Nicktedie123/Schallplattenspieler-VPE/cad/README.md

# CAD (STEP)

Hier liegen die neutralen CAD-Exporte (`.step`), die in jedem CAD-System geöffnet werden können.

**Export aus Fusion 360:** *Datei → Exportieren → Dateityp „STEP-Dateien (*.step)“*.

Empfohlene Dateinamen: `schallplattenspieler-gesamt.step`, `tonarm.step`, `zentrierdorn.step`.
