Nicktedie123/Schallplattenspieler-VPE/docs/anforderungsliste.pdf

# 3. Abgleich Anforderungsliste

F
/
W
Nr. | Bezeichnung | Wert gefordert | Wert aktuell | Überprü fung
1. Energie / Elektrik / Elektronik
F | 1.1 | Stromversorgung | mittels externem Netzteil DC 12V | DC 12V — Buchse 8320N131 vorhanden | CAD
F | 1.2 | Gesetze, Vorschriften und Bestimmungen für Elektrogeräte | zu beachten | Zu beachten — noch nicht vollst. geprüft | Norm-Prüfung
F | 1.3 | Schutz gegen elektrischen Schlag | kein Schaden | Alle spannungsführenden Teile abgedeckt (Abdeckung, Deckel_Motor) | CAD
F | 1.4 | Berührungs- und Fremdkörperschutz | keine Berührung | Abdeckungen auf allen Öffnungen vorhanden | CAD
F | 1.5 | Lautsprecheranschlus s | kabelgebunden | 2× 5432T17 GoldPlated RCA Buchsen integriert | CAD
2 | GEOMETRIE
F | 2.1 | Plattendurchmesser | 12 Zoll | Plattenteller — Ø 295 mm — passt für 12" | CAD
W | 2.2 | Plattendurchmesser | 7 und 12 Zoll
F | 2.3 | Zentrische Aufnahme der Platte | vorhanden | Zentrierdorn — Ø 7,24 mm | CAD
F | 2.4 | Keine scharfkantigen Teile | keine Kanten | Alle Kanten gefilleted in Fusion 360 | CAD

### 3 MECHANIK

3.1 | Bedienung des Tonarms | manuelle Bedienung | Lift-Hebel Manuelle Betätigung | CAD
3.2 | Horizontale Bewegung des Tonarms | geführt | Drehlager im pillar | CAD
3.3 | Vertikale Bewegung des Tonarms | geführt | Liftsystem_prototyp — Führung durch Drehlager | CAD

3.4 | | abwärts gedämpft | Feder v7 vorhanden — Dämpfung noch zu validieren | CAD
3.5 | Vertikale Bewegung des Tonarms | <30° | Mechanischer Anschlag im Liftsystem
3.6 | Auflagekraft des Tonarms | <40mN | Gegengewicht einstellbar
3.7 | Hohe Stabilität des Tonarms | keine bleibenden Verformungen | PLA-Tonarm — FEMAnalyse noch ausstehend | FEM
3.8 | Hohe Steifigkeit des Tonarms | möglichst geringe Verformungen | PLA-Tonarm — FEMAnalyse noch ausstehend | FEM
3.9 | Plattentellerantrieb | elektrisch | DC-Motor 8320N131 — elektrisch angetrieben | CAD
3.1 0 | Plattentellerantrieb | manuell ein-/ausschaltbar | Rocker Switch 7395K11 — EIN/AUS | CAD
3.1 1 | Plattentellerdrehzah | 33 1/3 min-1 | Slide Switch 66065K23 — 33⅓ RPM | CAD
3.1 2 | Plattentellerdrehzahl | 33 1/3 min-1 und 45 min-1 | Slide Switch — umschaltbar 33⅓ / 45 RPM | CAD
3.1 3 | Vibration auf Teller | geringe Übertragung | Riemenantrieb (Riemen v2) entkoppelt Motor vom Teller | CAD

4 ERGONOMIE
4.1 | Handhabungsteile | Ergonomische Griffform | Lift-Hebel v10 ergonomisch geformt | CAD

3.1
4 Umgebungsvibrationen
auf den Plattenspieler

geringe
Übertragung
3 Gummifüse | CAD

4.2 | Handhabungsteile | Ergonomische Positionierung | Bedienelemente auf Abdeckung zugänglich | CAD
4.3 | Schallplatte | leicht, ohne Hilfsmittel am Schallplattenrand abhebbar | Offenes Design — Schallplatte direkt zugänglich | CAD

### 5 Design

5.1 | Gesamtgestaltung | tbd (entsprechend Zielkundenkreis)

Dreiarm-Chassis
Design-modernes
Modell

CAD

6 | Einkauf
6.1 | Tonabnehmer | Zukaufteil | In Stückliste definiert (AT3600L_ Tonabnehmer) | Stücklist e
6.2 | Phono-Vorverstärker | Zukaufteil | In Stückliste definiert (PP400_Phono Vorverstaerker) | Stücklist e
6.3 | Externes Netzteil | Zukaufteil | DC-Buchse 8320N131 integriert | CAD
6.4 | Lautsprecher | Zukaufteil | 2× Lautsprecher v1 im Modell vorhanden | CAD

7 FERTIGUNG

8 Montage

6.5 Norm- und
Standardteile

möglichst viele DIN 7991/912/916, ISO 7380-1, SKF 6200,
McMaster-Carr Teile

Stücklist e

7.1 Herstellverfahren der
Einzelkomponenten

wenn möglich 3D
gedruckte Teile 15× 3D-Druck Bauteile (PLA/TPU) —
Mindestanford.
übertroffen

CAD
