Nicktedie123/Schallplattenspieler-VPE/docs/README.md

# Dokumentation

Hier können liegen:

- `stueckliste.pdf` oder `stueckliste.csv` (35 Positionen)
- kurze Zusammenfassung der Berechnungen
- Montagekonzept

Nur Unterlagen veröffentlichen, die das Team und die Hochschule freigegeben haben. Keine Bewertungsbögen oder Korrekturen.
