Nicktedie123/Schallplattenspieler-VPE/drawings/README.md

# Technische Zeichnungen (PDF)

Zeichnungen als PDF ablegen.

**Export aus Fusion 360:** Im Arbeitsbereich *Zeichnung* → *PDF exportieren*.
Dateinamen mit Positionsnummer aus der Stückliste, z. B. `pos-12-tonarm.pdf`.
