Nicktedie123/Schallplattenspieler-VPE/docs/stückliste.pdf

## 1.3 Stückliste

### Bauteil-/Stückliste

Nr. | Bauteilbezeichnung (Fusion 360) | Material | Anzahl | Typ
1 | Grundkörper | PLA | 1 | 3D-Druck
2 | Abdeckung | PLA | 1 | 3D-Druck
3 | Deckel_Motor | PLA | 1 | 3D-Druck
4 | Deckel_Bedienelement | PLA | 1 | 3D-Druck
5 | Zentrierdorn | Stahl | 1 | Drehteil
6 | Abstandshülse Lager | PLA | 1 | 3D-Druck
7 | Plattenteller | PLA | 1 | 3D-Druck
8 | Riemen | Silikon | 1 | Kaufteil
9 | Tonarm_Alu | Alumimium | 1 | Drehteil
10 | Tonarm_halter | PLA | 1 | 3D-Druck
11 | Tonarm_anschlag | PLA | 1 | 3D-Druck
12 | Gengengewicht | PLA | 1 | 3D-Druck
13 | Deckel_Tonarm | PLA | 1 | 3D-Druck
14 | Liftsystem_Prototyp | PLA | 1 | 3D-Druck
15 | Hebel | Alu | 1 | Biegeteil
16 | Feder | Alu | 1 | Kaufteil/ Normteil (2)
17 | Kugellager SKF-6200 | stahl | 2 | Kaufteil/ Normteil (3)
18 | 98455A127_Internal Retaining Ring | stahl | 1 | Kaufteil/ Normteil
19 | 98541A118_External Retaining Ring | stahl | 1 | Kaufteil/ Normteil
20 | 1598K32_Hardened Ultra-Wear-Resistant 440C Stainless Steel Ball | stahl | 1 | Kaufteil/ Normteil
21 | 8320N131_Barrel-Style DC Connector | | 1 | Kaufteil/ Normteil
22 | Lautsprecher | | 2 | Kaufteil (4)

23 | 60855K71_Vibration-Damping Rigid Leveling Mount | Gummi | 3 | Kaufteil/ Normteil
24 | 1598K32_Hardened Ultra-Wear-Resistant 440C Stainless Steel Ball | | 1 | Kaufteil/ Normteil
25 | 66065K23_Slide Switch | | 1 | Kaufteil (33/45 RPM)
26 | 7395K11_Rocker Switch | | 1 | Kaufteil
27 | 5432T17_Gold-Plated Brass Panel-Mount Coaxial Connector | | 2 | Kaufteil
28 | Tonabnehmer | | 1 | Kaufteil (5)
29 | Phono-Vorverstärker | | 1 | Kaufteil (Behringer pp400) (6)
30 | Elektromotor | | 1 | Kaufteil (7)
31 | Aufnahme Tonabnehmer | PLA | 1 | 3D-Druck
32 | Senkschraube M4 DIN 7991 | Stahl | 39 | Kaufteil/Normteil
33 | Senkschraube M5 DIN 7991 | Stahl | 3 | Kaufteil/Normteil
34 | Rundkopfschraube M3 ISO 7380 | Stahl | 8 | Kaufteil/Normteil
35 | Unterlegscheibe M3 DIN 125 | Stahl | 8 | Kaufteil/Normteil
36 | Sechskantmutter M3 DIN 934 | Stahl | 8 | Kaufteil/Normteil
37 | Zylinderkopfschraube M8 DIN 912 | Stahl | 3 | Kaufteil/Normteil

Alle Bauteile wurden so konstruiert, dass sie mit üblichen Fertigungsverfahren
| hergestellt werden können.
