Nicktedie123/Schallplattenspieler-VPE/cad/zentrierdorn.step

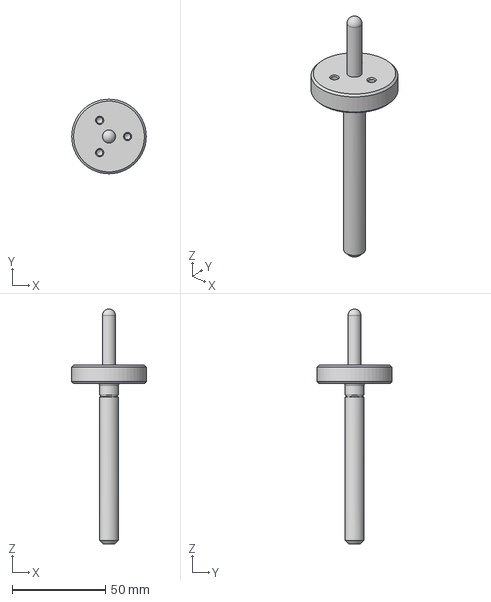
[picture p9: CAD file, 2026-10-26]
cad/zentrierdorn.step
40.0 x 40.0 x 126.0 mm
