Nicktedie123/Schallplattenspieler-VPE/cad/tonarm.step

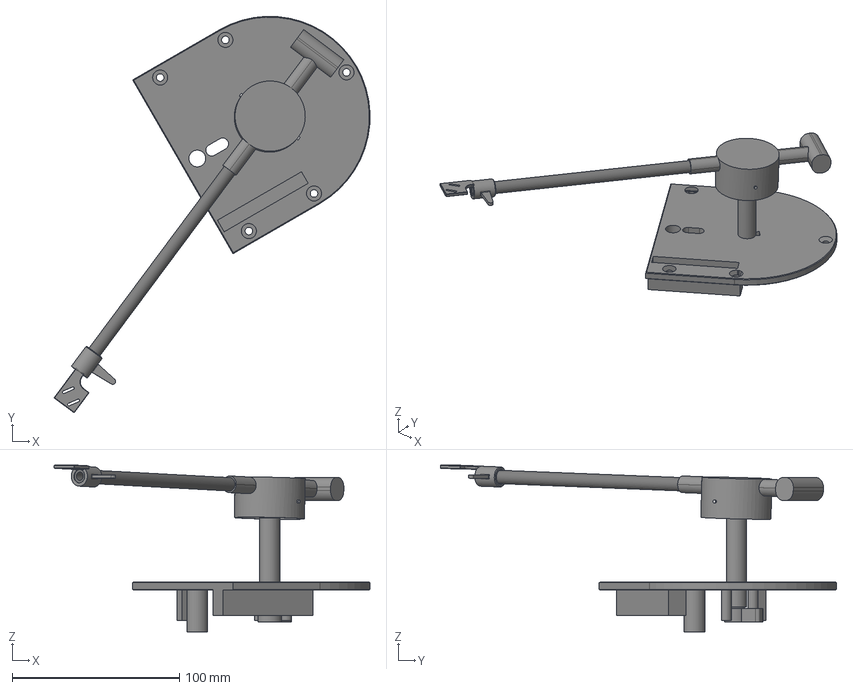
[picture p10: CAD file, 2026-10-26]
cad/tonarm.step
188.9 x 236.9 x 99.8 mm
pin
Tonarm_1
Tonarm_halter
Deckel_Tonarm
Tonarm_anschlag
Tonarm_Alu
Aufnahme Tonabnehmer
