Nicktedie123/Schallplattenspieler-VPE/cad/schallplattenspieler-gesamt.step

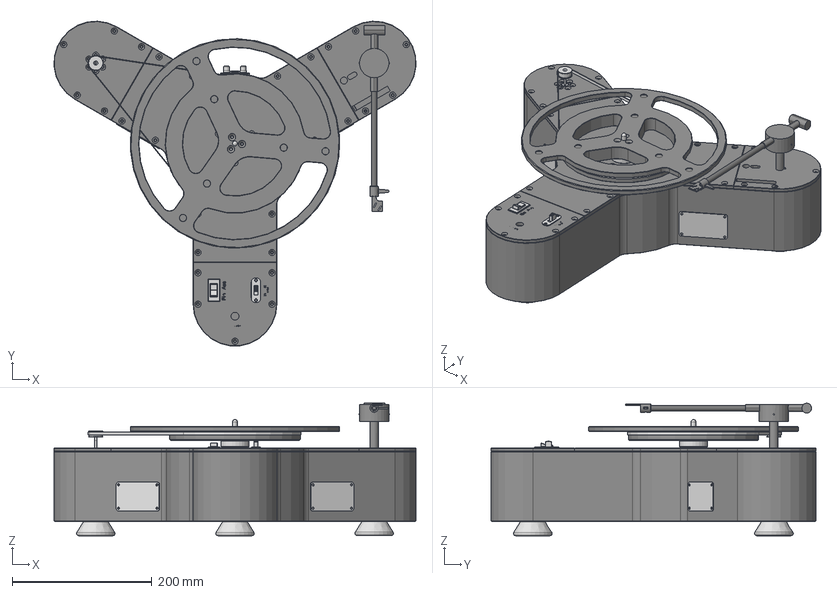
[picture p11: CAD file, 2026-10-26]
cad/schallplattenspieler-gesamt.step
518.0 x 464.5 x 189.6 mm
Grundkörper
Abdeckung
Deckel_Motor
Abstandshülse Lager
98455A127_Internal Retaining Ring
1598K32_Hardened Ultra-Wear-Resistant 440C Stainless Steel Ball
Zentrierdorn
98541A118_External Retaining Ring
Plattenteller
8320N131_Barrel-Style DC Connector
5432T17_Gold-Plated Brass Panel-Mount Coaxial Connector
5432T17_Gold-Plated Brass Panel-Mount Coaxial Connector_1
Deckel_Bedienelement
66065K23_Slide Switch
7395K11_Rocker Switch
Lautsprecher x 2
Elektromotor_Dummy
60855K71_Vibration-Damping Rigid Leveling Mount x 3
Riemen
pin
Tonarm_1
Tonarm_halter
Deckel_Tonarm
Tonarm_anschlag
Tonarm_Alu
Aufnahme Tonabnehmer
