Nicktedie123/Schallplattenspieler-VPE/drawings/zusammenbau.pdf

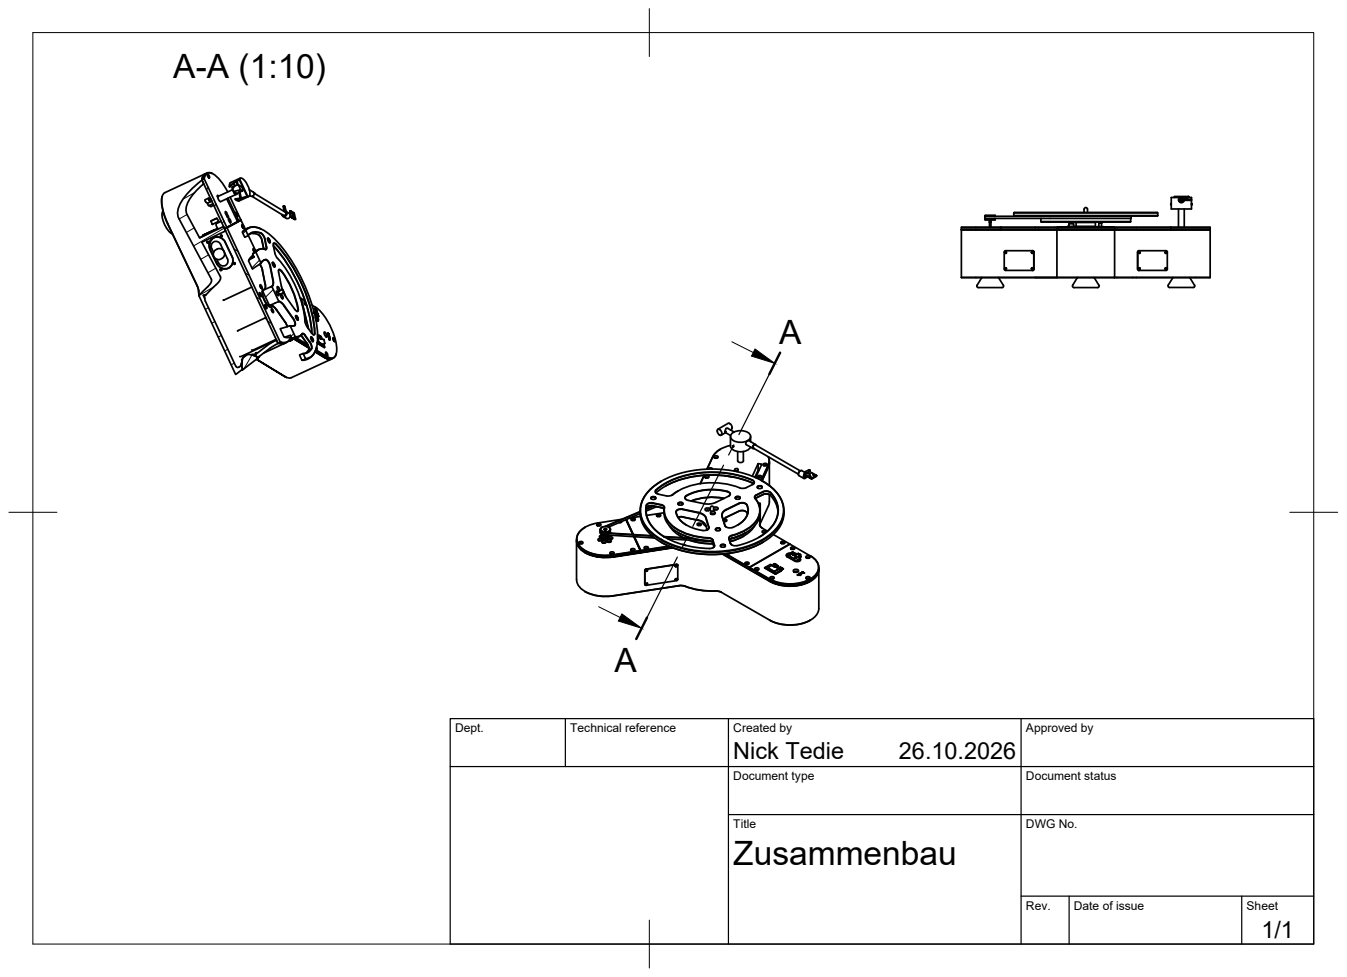
[picture p13: page 1]

Dept. | Technical reference | Created by Nick Tedie 26.10.2026 | Approved by

Document type | Document status

Title Zusammenbau | DWG No.

Rev. | Date of issue | Sheet 1/1
