Nicktedie123/Schallplattenspieler-VPE/(commit log)

2026-10-26 Initial commit: Schallplattenspieler VPE project
    [schallplattenspieler-gesamt.step, tonarm.step, zentrierdorn.step]
2026-10-26 Fix image file name case in README
